saumyadebug/robotic-arm-pick-and-place/WhatsApp Image 2026-10-22 at 6.11.43 PM.jpeg

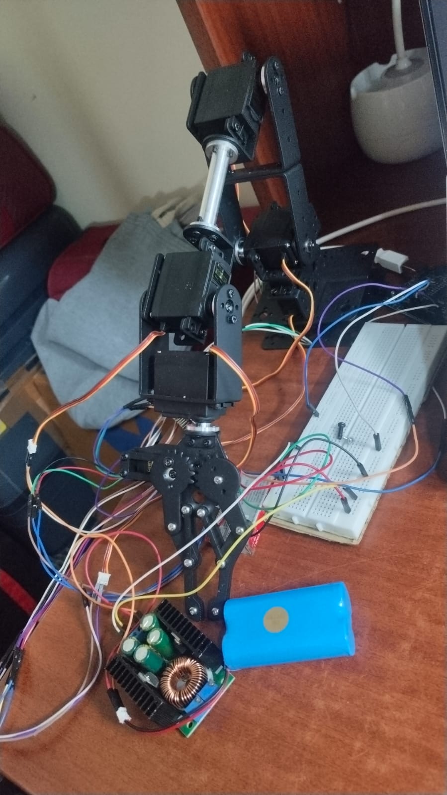
WhatsApp Image 2026-10-22 at 6.11.43 PM.jpeg
