saumyadebug/robotic-arm-pick-and-place/docs/motion_control.md

# Motion Control & Kinematics

## Inverse Kinematics vs Waypoint Navigation
For 4-DOF articulated planar arms, inverse kinematics (IK) computes joint angles $(\theta_1, \theta_2, \theta_3)$ given end-effector coordinates $(X, Y, Z)$:

$$\theta_1 = \text{atan2}(Y, X)$$

Using the geometric law of cosines:
$$r = \sqrt{X^2 + Y^2} - d_{\text{wrist}}$$
$$s = Z - h_{\text{base}}$$
$$D = \frac{r^2 + s^2 - L_1^2 - L_2^2}{2 L_1 L_2}$$
$$\theta_3 = \text{atan2}\left(\pm \sqrt{1 - D^2}, D\right)$$
$$\theta_2 = \text{atan2}(s, r) - \text{atan2}(L_2 \sin\theta_3, L_1 + L_2 \cos\theta_3)$$

---

## Trajectory Smoothing
Abrupt step changes in pulse values cause mechanical jerk and overshoot. Smooth trapezoidal velocity profiles or linear interpolation (LERP) are implemented between consecutive waypoints.

---

## Current implementation (2026-10-23)

This iteration uses **waypoint motion with operational clamps**, not inverse kinematics.

| Joint | Channel | Operational clamp | Role |
|---|---|---|---|
| Base | 0 | 335–415 | rotate only while arm is upright |
| Shoulder | 1 | 250–275 | stays vertical (260) to keep the arm balanced |
| Elbow | 2 | 205–310 | performs the reach down |
| Wrist pitch | 6 | 370–380 | held neutral |
| Gripper | 7 | 120 open / 200 closed | grasp/release |

Reach sequence: elbow **300 → 278 → 248 → 218**.
Lift sequence: elbow **218 → 240 → 262 → 284 → 300**, then shoulder back to 260.
The base rotates only after the arm is folded upright. This avoids the shoulder collapse seen with deep shoulder bends.

The next step after sensor integration is to add interpolation between these waypoints; inverse kinematics remains deferred.
