saumyadebug/robotic-arm-pick-and-place/tests/ultrasonic_test_results.md

# Ultrasonic Sensor Test Results

Sensor: **HC-SR04**  
Target: 30mm wooden test cube

| Actual Distance (cm) | Measured Distance (cm) | Error (cm) | Object Detection Trigger |
|---|---|---|---|
| 2.0 | 2.1 | +0.1 | YES |
| 4.0 | 4.0 | 0.0 | YES |
| 6.0 | 5.9 | -0.1 | YES |
| 8.0 | 8.1 | +0.1 | YES |
| 10.0 | 10.0 | 0.0 | YES (Boundary) |
| 12.0 | 11.9 | -0.1 | NO |
| 15.0 | 15.2 | +0.2 | NO |
