saumyadebug/robotic-arm-pick-and-place/(commit log)

2026-10-19 README file is created
    Added project details including hardware components, tools, current progress, and status.
2026-10-22 Refocus on pick-and-place stabilization: safe sequential motion, revert wrist roll/yellow
    [color_sensor_test.ino, integrated_sorting.ino, pick_and_place.ino]
2026-10-22 Add safe motion chart for joint ranges and pick-and-place waypoints
2026-10-22 Calibrated channels/ranges, compact-transport pick-and-place, safe motion chart
2026-10-22 Minimal safe motion: hard-clamped small ranges, upright-only base rotation, one joint at a time
2026-10-22 Elbow-only reach with staged lift; shoulder stays vertical to prevent collapse
    [pick_and_place.ino]
2026-10-22 Keep gripper open when rotating home
2026-10-22 Stable elbow-reach motion, sensor integration firmware, wiring guide and updated docs
